biancanev/levitas_pcb/pcb/levitas_v2/Levitas3_Chip_Project/schematic_preview.png

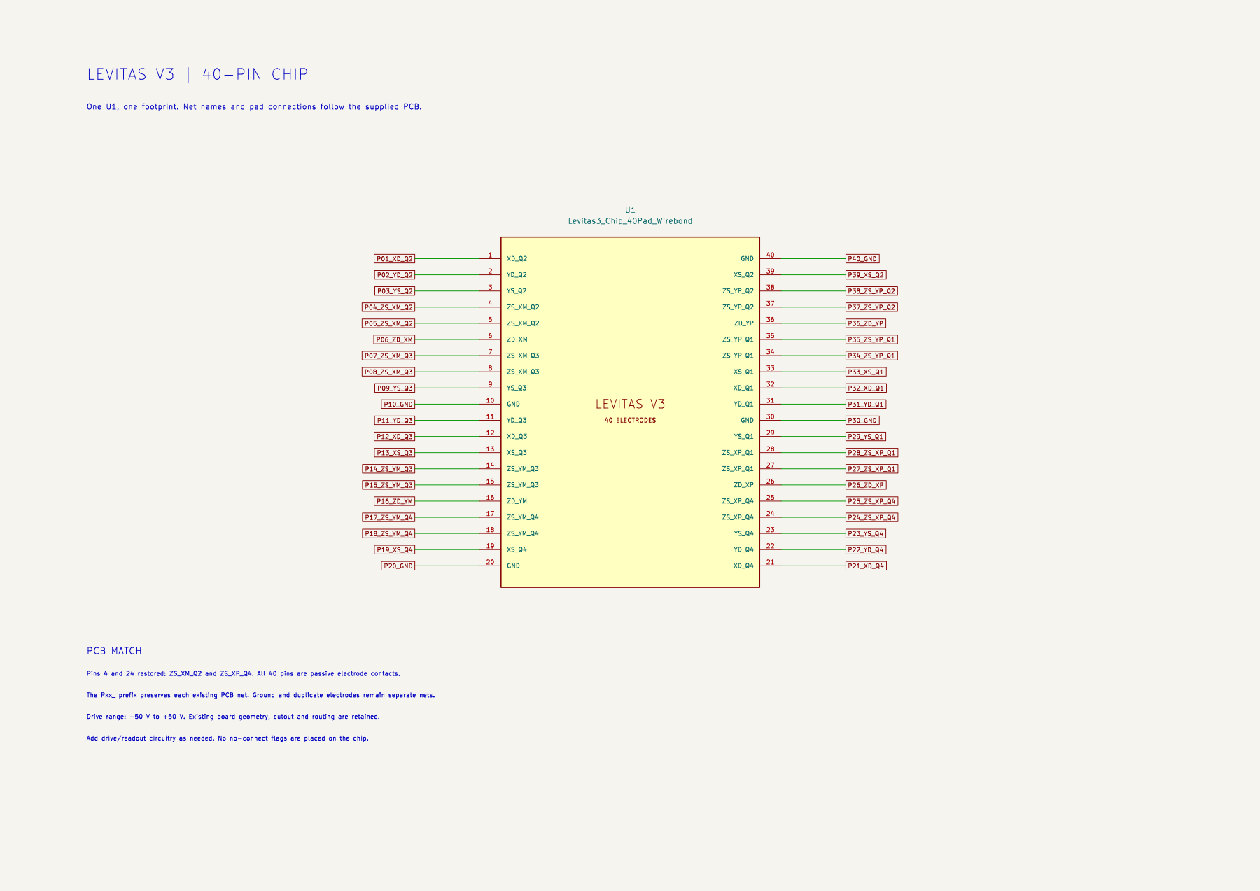
pcb/levitas_v2/Levitas3_Chip_Project/schematic_preview.png
