biancanev/levitas_pcb/pcb/levitas_v2/production/bom.csv

Designator | Footprint | Quantity | Value | LCSC Part #
C1, C10, C13, C16, C19, C22, C4, C41, C43, C45, C7 | 0805 | 11 | 4.7u
C11, C14, C17, C2, C20, C23, C39, C40, C42, C46, C5, C8 | 0603 | 12 | 100n
C12, C15, C18, C21, C24, C3, C6, C9 | 0603 | 8 | 33p
C25, C26, C27, C28, C29, C30, C31, C32, C33, C34, C35, C36 | 0805 | 12 | 470p
C37, C38 | 0805 | 2 | 1u
C39_2 | 0603 | 1 | 0.1u
C44 | C_Disc_D7.5mm_W2.5mm_P5.00mm | 1 | 10n
D1 | LED_D5.0mm | 1 | LED
D2 | D_DO-41_SOD81_P10.16mm_Horizontal | 1 | D
D3 | D_DO-41_SOD81_P10.16mm_Horizontal | 1 | 1N1004
F1, F2, F3, F4 | R_Axial_DIN0207_L6.3mm_D2.5mm_P7.62mm_Horizontal | 4 | Polyfuse
J1 | PinSocket_1x20_P2.54mm_Vertical | 1 | RPI_L
J19 | PinHeader_1x02_P2.54mm_Vertical | 1 | J_DA_CSM
J2 | PinSocket_1x20_P2.54mm_Vertical | 1 | RPI_R
J20 | PinHeader_1x02_P2.54mm_Vertical | 1 | J_DB_SCLK
J21 | PinHeader_1x02_P2.54mm_Vertical | 1 | J_DA_MOSI
J22 | PinHeader_1x04_P2.54mm_Vertical | 1 | J_HV_OUT
J23 | PinHeader_1x02_P2.54mm_Vertical | 1 | J_3V3_EXT
J3 | PinHeader_1x04_P2.54mm_Vertical | 1 | J_HVA
J4 | PinHeader_1x04_P2.54mm_Vertical | 1 | J_HVB
J5 | PinHeader_1x04_P2.54mm_Vertical | 1 | J_HVC
J6 | PinHeader_1x24_P2.54mm_Vertical | 1 | J_HV
J7 | PinSocket_1x08_P2.54mm_Vertical | 1 | J_MPU
JP23 | PinHeader_1x02_P2.54mm_Vertical | 1 | Jumper_2_Bridged
L1, L2, L3, L4, L5, L6, L7, L8 | 0603 | 8 | 18u
R1, R10, R11, R12, R13, R14, R15, R16, R2, R3, R4, R5, R6, R7, R8, R9 | 0603 | 16 | 4.7k
R17, R18, R19, R20, R21, R22, R23, R24, R25, R26, R27, R28 | 1206 | 12 | 10k
R29, R34, R35, R36 | R_Axial_DIN0207_L6.3mm_D2.5mm_P7.62mm_Horizontal | 4 | 5k
R32 | R_Axial_DIN0207_L6.3mm_D2.5mm_P7.62mm_Horizontal | 1 | 220
R33 | R_Axial_DIN0207_L6.3mm_D2.5mm_P7.62mm_Horizontal | 1 | 1M
TP1 | TestPoint_Pad_D1.0mm | 1 | 3V3_A_TP
TP10, TP12, TP14, TP16, TP2, TP4, TP6, TP8 | TestPoint_Pad_D1.0mm | 8 | TestPoint
TP3 | TestPoint_Pad_D1.0mm | 1 | 5v_TP
TP5 | TestPoint_Pad_D1.0mm | 1 | GND_TP
U1 | Levitas3_Chip_40Pad_Wirebond | 1 | Levitas3_Chip_40Pad_Wirebond
U10 | TSSOP-24_4.4x7.8mm_P0.65mm | 1 | HV264
U11 | DRV0006A | 1 | TLV75533PDRVR
U12 | TSSOP-14_4.4x5mm_P0.65mm | 1 | MAX5715
U13 | Q025-5C | 1 | Q025-5C
U2, U3, U4, U5, U6, U7, U8, U9 | WSON-12-1EP_4x4mm_P0.5mm_EP2.6x3mm | 8 | FDC2112
