biancanev/levitas_pcb/pcb/levitas_v2/levitas_v2.csv

Reference | Qty | Value | DNP | Exclude from BOM | Exclude from Board | Footprint | Datasheet
C1,C4,C7,C10,C13,C16,C19,C22 | 8 | 4.7u |  |  |  | Capacitor_SMD:C_0805_2012Metric
C2,C5,C8,C11,C14,C17,C20,C23 | 8 | 100n |  |  |  | Capacitor_SMD:C_0603_1608Metric
C3,C6,C9,C12,C15,C18,C21,C24 | 8 | 33p |  |  |  | Capacitor_SMD:C_0504_1310Metric_Pad0.83x1.28mm_HandSolder
C25,C26,C27,C28,C29,C30,C31,C32,C33,C34,C35,C36 | 12 | 470p
C37,C38 | 2 | 1u
C39 | 1 | 0.1u
J1 | 1 | RPI_L |  |  |  | Connector_PinSocket_2.54mm:PinSocket_1x20_P2.54mm_Vertical
J2 | 1 | RPI_R |  |  |  | Connector_PinSocket_2.54mm:PinSocket_1x20_P2.54mm_Vertical
J3 | 1 | J_HVA |  |  |  | Connector_PinHeader_2.54mm:PinHeader_1x04_P2.54mm_Vertical
J4 | 1 | J_HVB |  |  |  | Connector_PinHeader_2.54mm:PinHeader_1x04_P2.54mm_Vertical
J5 | 1 | J_HVC |  |  |  | Connector_PinHeader_2.54mm:PinHeader_1x04_P2.54mm_Vertical
J6 | 1 | J_HV |  |  |  | Connector_PinHeader_2.54mm:PinHeader_1x24_P2.54mm_Vertical
J7 | 1 | J_MPU |  |  |  | Connector_PinSocket_2.54mm:PinSocket_1x08_P2.54mm_Vertical
L1,L2,L3,L4,L5,L6,L7,L8 | 8 | 18u |  |  |  | Inductor_SMD:L_0603_1608Metric
R1,R2,R3,R4,R5,R6,R7,R8,R9,R10,R11,R12,R13,R14,R15,R16 | 16 | 4.7k |  |  |  | Resistor_SMD:R_0603_1608Metric
R17,R18,R19,R20,R21,R22,R23,R24,R25,R26,R27,R28 | 12 | 10k
TP1 | 1 | 3V3_A_TP |  |  |  | TestPoint:TestPoint_Pad_D1.0mm
TP2,TP4,TP6,TP8,TP10,TP12,TP14,TP16 | 8 | TestPoint |  |  |  | TestPoint:TestPoint_Pad_D1.0mm
TP3 | 1 | 5v_TP |  |  |  | TestPoint:TestPoint_Pad_D1.0mm
TP5 | 1 | GND_TP |  |  |  | TestPoint:TestPoint_Pad_D1.0mm
U1 | 1 | Levitas3_Chip_40Pad_Wirebond |  |  |  | levitas_v3_footprint:Levitas3_Chip_40Pad_Wirebond
U2,U3,U4,U5,U6,U7,U8,U9 | 8 | FDC2112 |  |  |  | levitas_local:WSON-12-1EP_4x4mm_P0.5mm_EP2.6x3mm
U10 | 1 | 74AHCT244 |  |  |  |  | https://assets.nexperia.com/documents/data-sheet/74AHC_AHCT244.pdf
U11 | 1 | TLV75533PDRVR |  |  |  | TLV755:DRV0006A | https://www.ti.com/lit/gpn/tlv755p
