biancanev/levitas_pcb/(list of files, drawings)

Other design files:
pcb/levitas_v2/Levitas3_Chip_Project/source/pcb_pin_map.json
