biancanev/levitas_pcb/pcb/levitas_v2/levitas_v2.kicad_pcb

## KiCad design pcb/levitas_v2/levitas_v2.kicad_pcb (2026-11-06)

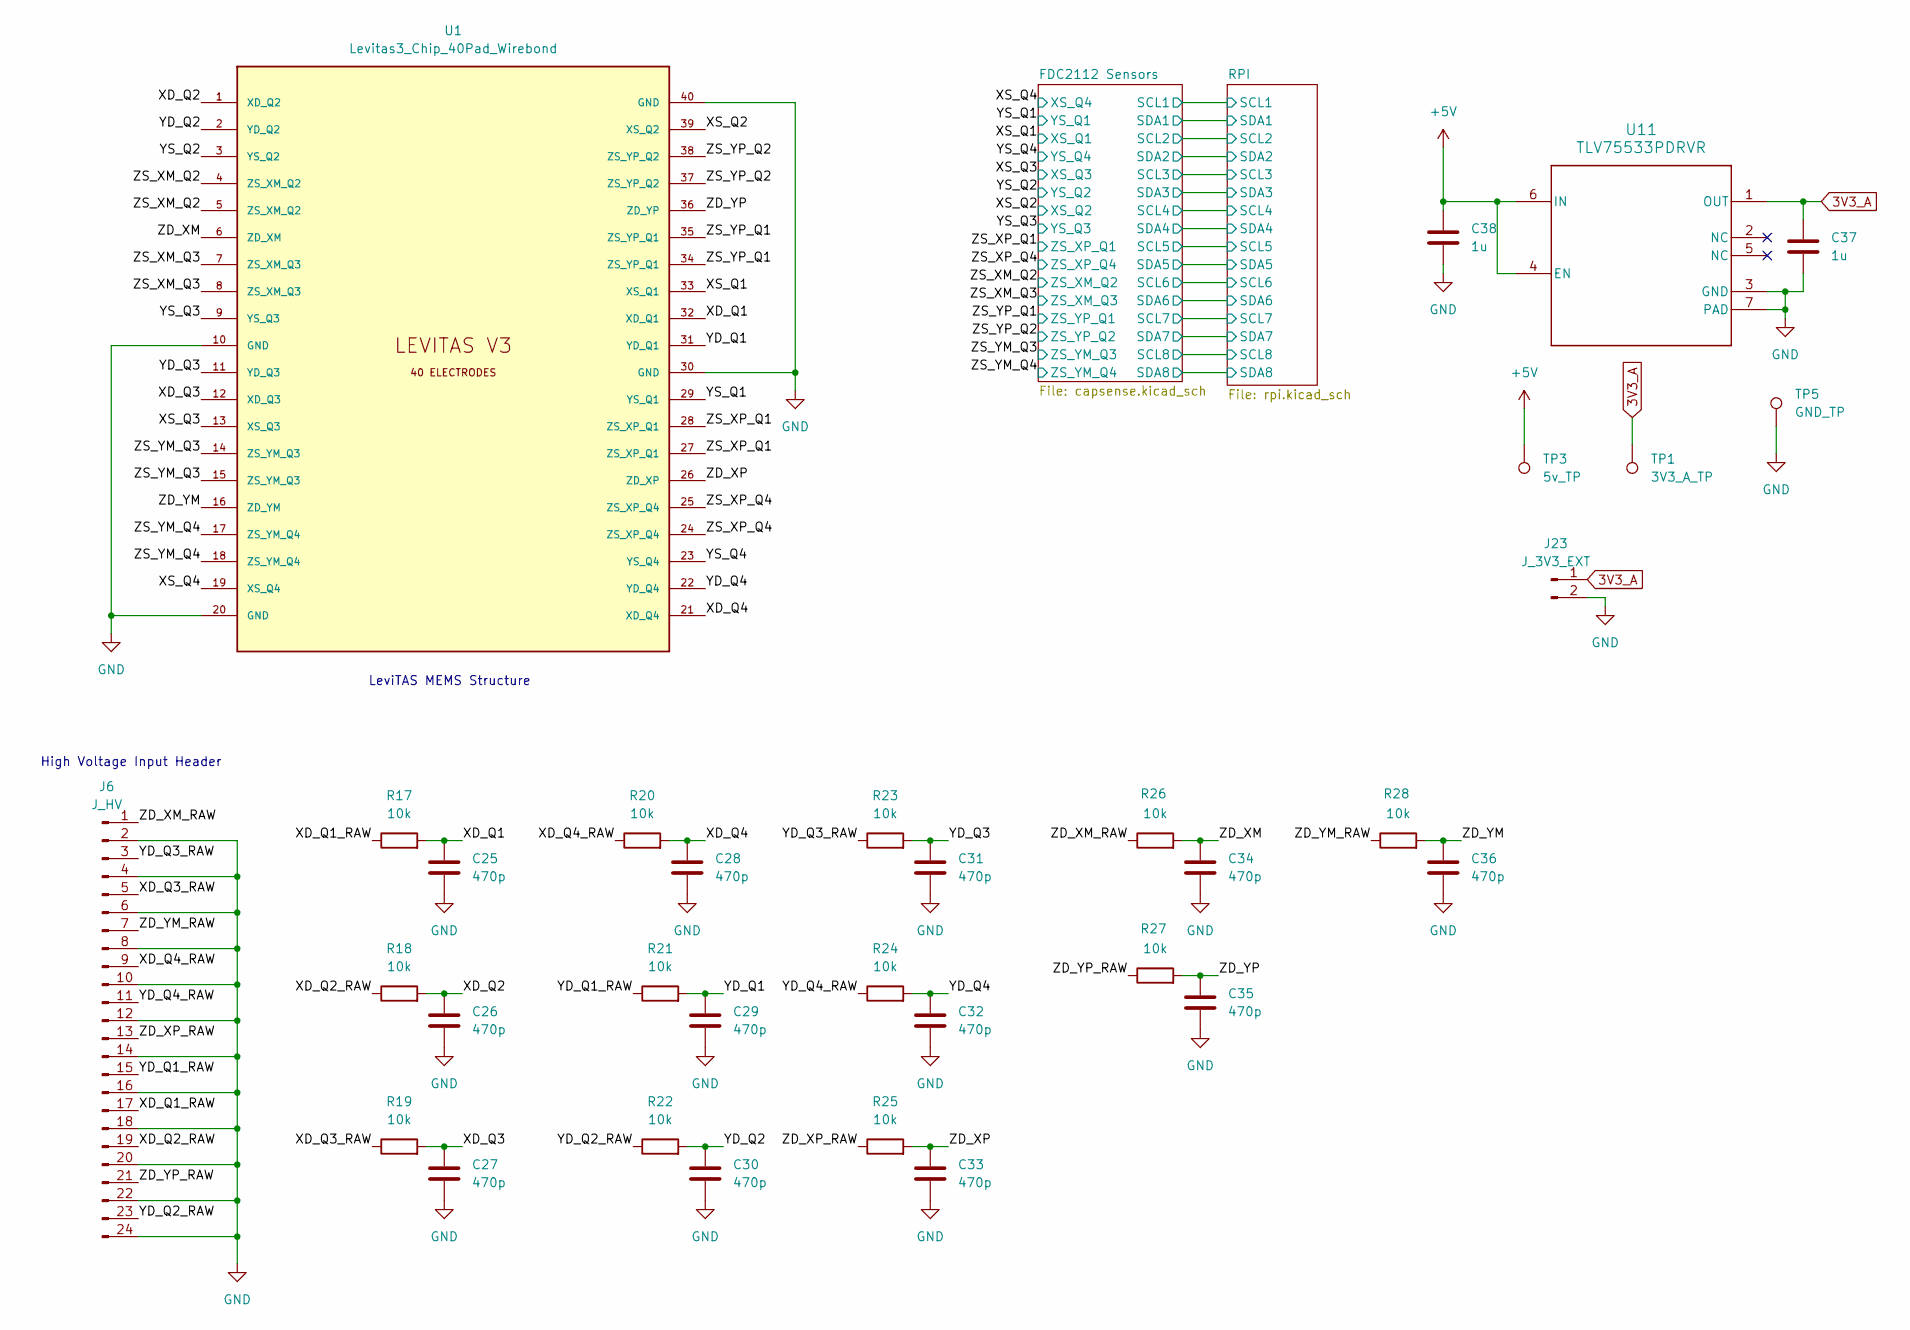
[picture p2: schematic levitas_v2.kicad_sch]

Parts:
C25, C26, C27, C28, C29, C30, C31, C32, C33, C34, C35, C36: 470p; C_0805_2012Metric
C37, C38: 1u; C_0805_2012Metric
J6: J_HV; PinHeader_1x24_P2.54mm_Vertical
J23: J_3V3_EXT; PinHeader_1x02_P2.54mm_Vertical
R17, R18, R19, R20, R21, R22, R23, R24, R25, R26, R27, R28: 10k; R_1206_3216Metric
TP1: 3V3_A_TP; TestPoint_Pad_D1.0mm
TP3: 5v_TP; TestPoint_Pad_D1.0mm
TP5: GND_TP; TestPoint_Pad_D1.0mm
U1: Levitas3_Chip_40Pad_Wirebond
U11: TLV75533PDRVR; DRV0006A

Connections:
/XD_Q1: C25.1, R17.2, U1.32 (XD_Q1)
/XD_Q1_RAW: J6.17, R17.1
/XD_Q2: C26.1, R18.2, U1.1 (XD_Q2)
/XD_Q2_RAW: J6.19, R18.1
/XD_Q3: C27.1, R19.2, U1.12 (XD_Q3)
/XD_Q3_RAW: J6.5, R19.1
/XD_Q4: C28.1, R20.2, U1.21 (XD_Q4)
/XD_Q4_RAW: J6.9, R20.1
/XS_Q1: U1.33 (XS_Q1); also elsewhere on the board
/XS_Q2: U1.39 (XS_Q2); also elsewhere on the board
/XS_Q3: U1.13 (XS_Q3); also elsewhere on the board
/XS_Q4: U1.19 (XS_Q4); also elsewhere on the board
/YD_Q1: C29.1, R21.2, U1.31 (YD_Q1)
/YD_Q1_RAW: J6.15, R21.1
/YD_Q2: C30.1, R22.2, U1.2 (YD_Q2)
/YD_Q2_RAW: J6.23, R22.1
/YD_Q3: C31.1, R23.2, U1.11 (YD_Q3)
/YD_Q3_RAW: J6.3, R23.1
/YD_Q4: C32.1, R24.2, U1.22 (YD_Q4)
/YD_Q4_RAW: J6.11, R24.1
/YS_Q1: U1.29 (YS_Q1); also elsewhere on the board
/YS_Q2: U1.3 (YS_Q2); also elsewhere on the board
/YS_Q3: U1.9 (YS_Q3); also elsewhere on the board
/YS_Q4: U1.23 (YS_Q4); also elsewhere on the board
/ZD_XM: C34.1, R26.2, U1.6 (ZD_XM)
/ZD_XM_RAW: J6.1, R26.1
/ZD_XP: C33.1, R25.2, U1.26 (ZD_XP)
/ZD_XP_RAW: J6.13, R25.1
/ZD_YM: C36.1, R28.2, U1.16 (ZD_YM)
/ZD_YM_RAW: J6.7, R28.1
/ZD_YP: C35.1, R27.2, U1.36 (ZD_YP)
/ZD_YP_RAW: J6.21, R27.1
/ZS_XM_Q2: U1.4 (ZS_XM_Q2), U1.5 (ZS_XM_Q2); also elsewhere on the board
/ZS_XM_Q3: U1.7 (ZS_XM_Q3), U1.8 (ZS_XM_Q3); also elsewhere on the board
/ZS_XP_Q1: U1.27 (ZS_XP_Q1), U1.28 (ZS_XP_Q1); also elsewhere on the board
/ZS_XP_Q4: U1.24 (ZS_XP_Q4), U1.25 (ZS_XP_Q4); also elsewhere on the board
/ZS_YM_Q3: U1.14 (ZS_YM_Q3), U1.15 (ZS_YM_Q3); also elsewhere on the board
/ZS_YM_Q4: U1.17 (ZS_YM_Q4), U1.18 (ZS_YM_Q4); also elsewhere on the board
/ZS_YP_Q1: U1.34 (ZS_YP_Q1), U1.35 (ZS_YP_Q1); also elsewhere on the board
/ZS_YP_Q2: U1.37 (ZS_YP_Q2), U1.38 (ZS_YP_Q2); also elsewhere on the board
GND: C25.2, C26.2, C27.2, C28.2, C29.2, C30.2, C31.2, C32.2, C33.2, C34.2, C35.2, C36.2, C37.2, C38.2, J6.2, J6.4, J6.6, J6.8, J6.10, J6.12, J6.14, J6.16, J6.18, J6.20, J6.22, J6.24, J23.2, TP5.1 (1_1), U1.10 (GND), U1.20 (GND), U1.30 (GND), U1.40 (GND), U11.3 (GND), U11.7 (PAD); also elsewhere on the board

Notes on the sheet:
High Voltage Input Header
LeviTAS MEMS Structure

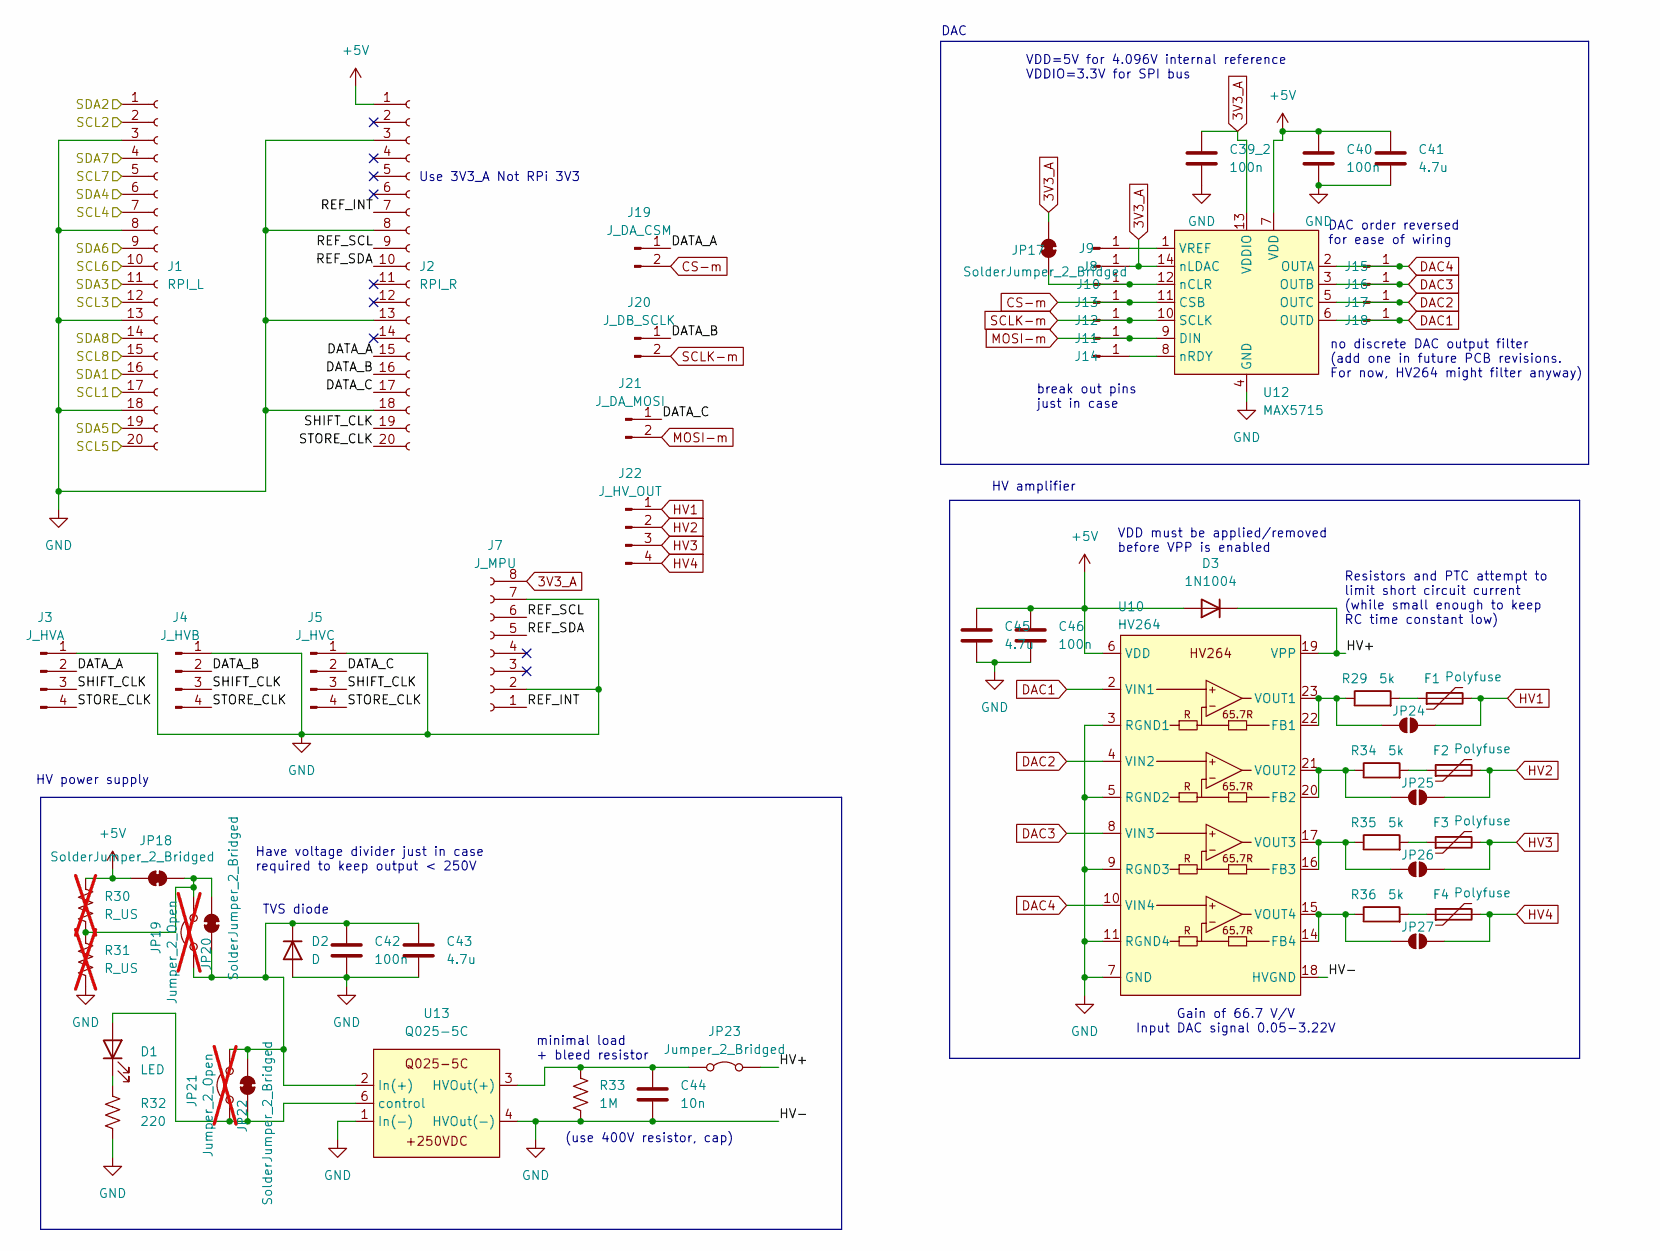
[picture p3: schematic rpi.kicad_sch]

Parts:
C39_2, C40, C42, C46: 100n; C_0603_1608Metric
C41, C43, C45: 4.7u; C_0805_2012Metric
C44: 10n; C_Disc_D7.5mm_W2.5mm_P5.00mm
D1: LED; LED_D5.0mm
D2: D; D_DO-41_SOD81_P10.16mm_Horizontal
D3: 1N1004; D_DO-41_SOD81_P10.16mm_Horizontal
F1, F2, F3, F4: Polyfuse; R_Axial_DIN0207_L6.3mm_D2.5mm_P7.62mm_Horizontal
J1: RPI_L; PinSocket_1x20_P2.54mm_Vertical
J2: RPI_R; PinSocket_1x20_P2.54mm_Vertical
J3: J_HVA; PinHeader_1x04_P2.54mm_Vertical
J4: J_HVB; PinHeader_1x04_P2.54mm_Vertical
J5: J_HVC; PinHeader_1x04_P2.54mm_Vertical
J7: J_MPU; PinSocket_1x08_P2.54mm_Vertical
J8, J9, J10, J11, J12, J13, J14, J15, J16, J17, J18: Conn_01x01_Pin; TestPoint_Pad_D2.0mm
J19: J_DA_CSM; PinHeader_1x02_P2.54mm_Vertical
J20: J_DB_SCLK; PinHeader_1x02_P2.54mm_Vertical
J21: J_DA_MOSI; PinHeader_1x02_P2.54mm_Vertical
J22: J_HV_OUT; PinHeader_1x04_P2.54mm_Vertical
JP17, JP18, JP20, JP22: SolderJumper_2_Bridged; SolderJumper-2_P1.3mm_Bridged_RoundedPad1.0x1.5mm
JP19, JP21: Jumper_2_Open; PinHeader_1x02_P2.54mm_Vertical; not fitted
JP23: Jumper_2_Bridged; PinHeader_1x02_P2.54mm_Vertical
JP24, JP25, JP26, JP27: SolderJumper_2_Open; SolderJumper-2_P1.3mm_Open_RoundedPad1.0x1.5mm
R29, R34, R35, R36: 5k; R_Axial_DIN0207_L6.3mm_D2.5mm_P7.62mm_Horizontal
R30, R31: R_US; R_Axial_DIN0207_L6.3mm_D2.5mm_P7.62mm_Horizontal; not fitted
R32: 220; R_Axial_DIN0207_L6.3mm_D2.5mm_P7.62mm_Horizontal
R33: 1M; R_Axial_DIN0207_L6.3mm_D2.5mm_P7.62mm_Horizontal
U10: HV264; TSSOP-24_4.4x7.8mm_P0.65mm
U12: MAX5715; TSSOP-14_4.4x5mm_P0.65mm
U13: Q025-5C

Connections:
/FDC2112 Sensors/SCL1: J1.17; also elsewhere on the board
/FDC2112 Sensors/SCL2: J1.2; also elsewhere on the board
/FDC2112 Sensors/SCL3: J1.12; also elsewhere on the board
/FDC2112 Sensors/SCL4: J1.7; also elsewhere on the board
/FDC2112 Sensors/SCL5: J1.20; also elsewhere on the board
/FDC2112 Sensors/SCL6: J1.10; also elsewhere on the board
/FDC2112 Sensors/SCL7: J1.5; also elsewhere on the board
/FDC2112 Sensors/SCL8: J1.15; also elsewhere on the board
/FDC2112 Sensors/SDA1: J1.16; also elsewhere on the board
/FDC2112 Sensors/SDA2: J1.1; also elsewhere on the board
/FDC2112 Sensors/SDA3: J1.11; also elsewhere on the board
/FDC2112 Sensors/SDA4: J1.6; also elsewhere on the board
/FDC2112 Sensors/SDA5: J1.19; also elsewhere on the board
/FDC2112 Sensors/SDA6: J1.9; also elsewhere on the board
/FDC2112 Sensors/SDA7: J1.4; also elsewhere on the board
/FDC2112 Sensors/SDA8: J1.14; also elsewhere on the board
/RPI/DATA_A: J2.15, J3.2, J19.1
/RPI/DATA_B: J2.16, J4.2, J20.1
/RPI/DATA_C: J2.17, J5.2, J21.1
/RPI/HV+: D3.1 (K), JP23.2 (B), U10.19 (VPP)
/RPI/REF_INT: J2.7, J7.1
/RPI/REF_SCL: J2.9, J7.6
/RPI/REF_SDA: J2.10, J7.5
/RPI/SHIFT_CLK: J2.19, J3.3, J4.3, J5.3
/RPI/STORE_CLK: J2.20, J3.4, J4.4, J5.4
CS-m: J13.1, J19.2, U12.11 (CSB)
DAC1: J18.1, U10.2 (VIN1), U12.6 (OUTD)
DAC2: J17.1, U10.4 (VIN2), U12.5 (OUTC)
DAC3: J16.1, U10.8 (VIN3), U12.3 (OUTB)
DAC4: J15.1, U10.10 (VIN4), U12.2 (OUTA)
GND: C39_2.2, C40.2, C41.2, C42.2, C43.2, C44.2, C45.2, C46.2, D2.2 (A), J1.3, J1.8, J1.13, J1.18, J2.3, J2.8, J2.13, J2.18, J3.1, J4.1, J5.1, J7.2, J7.7, R31.2, R32.2, R33.2, U10.3 (RGND1), U10.5 (RGND2), U10.7 (GND), U10.9 (RGND3), U10.11 (RGND4), U10.18 (HVGND), U12.4 (GND), U13.1 (In(-)), U13.4 (HVOut(-)); also elsewhere on the board
HV1: F1.2, J22.1, JP24.2 (B)
HV2: F2.2, J22.2, JP25.2 (B)
HV3: F3.2, J22.3, JP26.2 (B)
HV4: F4.2, J22.4, JP27.2 (B)
MOSI-m: J11.1, J21.2, U12.9 (DIN)
unnamed: D1.2 (A), JP21.1 (A), JP22.1 (A), U13.6 (control)
unnamed: D1.1 (K), R32.1
unnamed: C42.1, C43.1, D2.1 (K), JP19.1 (A), JP20.1 (A), JP21.2 (B), JP22.2 (B), U13.2 (In(+))
unnamed: F1.1, R29.2
unnamed: F2.1, R34.2
unnamed: F3.1, R35.2
unnamed: F4.1, R36.2
unnamed: J9.1, U12.1 (VREF)
unnamed: J10.1, JP17.2 (B), U12.12 (nCLR)
unnamed: J14.1, U12.8 (nRDY)
unnamed: JP18.1 (A), JP19.2 (B), JP20.2 (B), R30.2, R31.1
unnamed: C44.1, JP23.1 (A), R33.1, U13.3 (HVOut(+))
unnamed: JP24.1 (A), R29.1, U10.22 (FB1), U10.23 (VOUT1)
unnamed: JP25.1 (A), R34.1, U10.20 (FB2), U10.21 (VOUT2)
unnamed: JP26.1 (A), R35.1, U10.16 (FB3), U10.17 (VOUT3)
unnamed: JP27.1 (A), R36.1, U10.14 (FB4), U10.15 (VOUT4)
SCLK-m: J12.1, J20.2, U12.10 (SCLK)

Notes on the sheet:
VDD=5V for 4.096V internal reference VDDIO=3.3V for SPI bus
DAC
VDD must be applied/removed before VPP is enabled
Resistors and PTC attempt to limit short circuit current (while small enough to keep RC time constant low)
TVS diode
DAC order reversed for ease of wiring
minimal load + bleed resistor
Have voltage divider just in case required to keep output < 250V
HV power supply
(use 400V resistor, cap)
break out pins just in case
Use 3V3_A Not RPi 3V3
no discrete DAC output filter (add one in future PCB revisions. For now, HV264 might filter anyway)
Gain of 66.7 V/V Input DAC signal 0.05-3.22V
HV amplifier

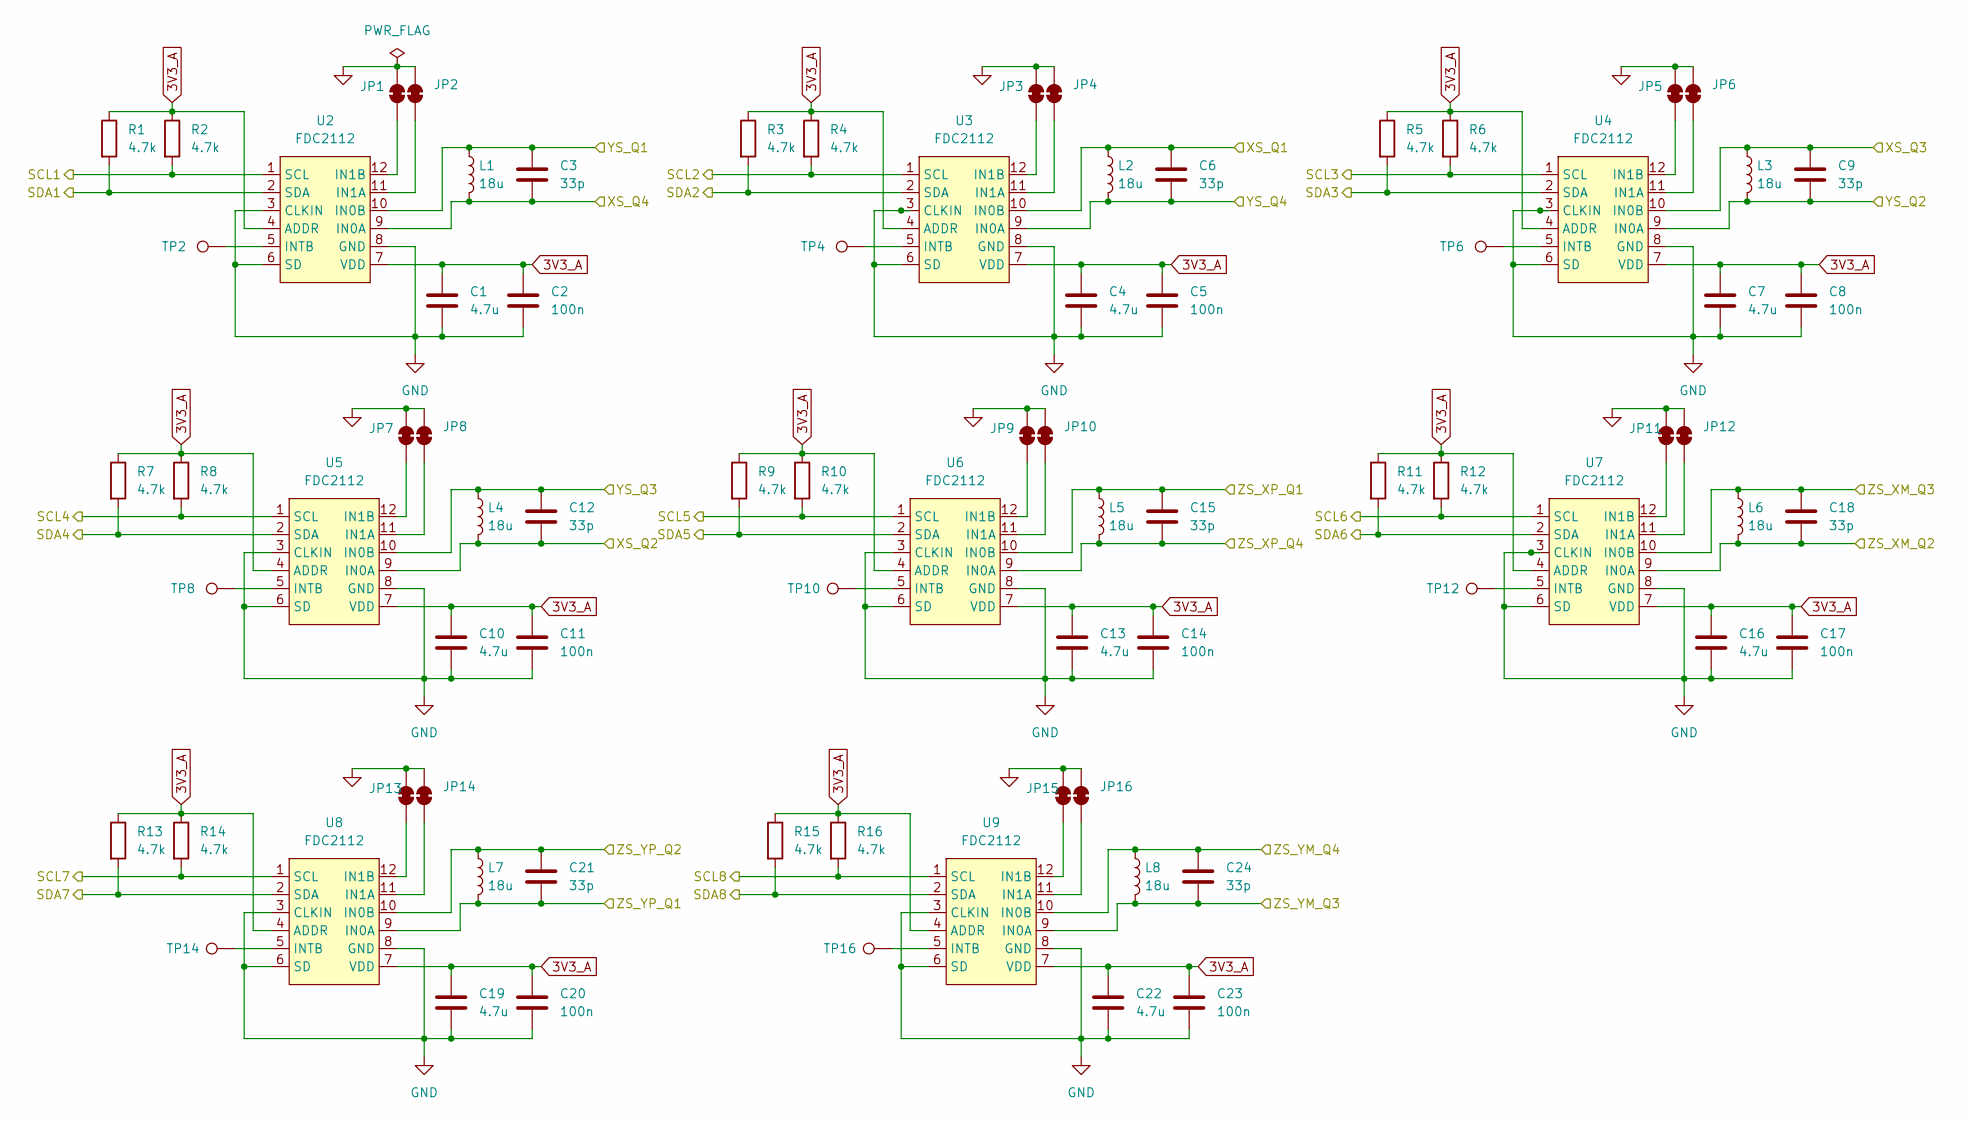
[picture p4: schematic capsense.kicad_sch]

Parts:
C1, C4, C7, C10, C13, C16, C19, C22: 4.7u; C_0805_2012Metric
C2, C5, C8, C11, C14, C17, C20, C23: 100n; C_0603_1608Metric
C3, C6, C9, C12, C15, C18, C21, C24: 33p; C_0603_1608Metric
JP1, JP2, JP3, JP4, JP5, JP6, JP7, JP8, JP9, JP10, JP11, JP12, JP13, JP14, JP15, JP16: SolderJumper_2_Bridged; SolderJumper-2_P1.3mm_Bridged_RoundedPad1.0x1.5mm
L1, L2, L3, L4, L5, L6, L7, L8: 18u; L_0603_1608Metric
R1, R2, R3, R4, R5, R6, R7, R8, R9, R10, R11, R12, R13, R14, R15, R16: 4.7k; R_0603_1608Metric
TP2, TP4, TP6, TP8, TP10, TP12, TP14, TP16: TestPoint; TestPoint_Pad_D1.0mm
U2, U3, U4, U5, U6, U7, U8, U9: FDC2112; WSON-12-1EP_4x4mm_P0.5mm_EP2.6x3mm

Connections:
/FDC2112 Sensors/SCL1: R2.2, U2.1 (SCL); also elsewhere on the board
/FDC2112 Sensors/SCL2: R4.2, U3.1 (SCL); also elsewhere on the board
/FDC2112 Sensors/SCL3: R6.2, U4.1 (SCL); also elsewhere on the board
/FDC2112 Sensors/SCL4: R8.2, U5.1 (SCL); also elsewhere on the board
/FDC2112 Sensors/SCL5: R10.2, U6.1 (SCL); also elsewhere on the board
/FDC2112 Sensors/SCL6: R12.2, U7.1 (SCL); also elsewhere on the board
/FDC2112 Sensors/SCL7: R14.2, U8.1 (SCL); also elsewhere on the board
/FDC2112 Sensors/SCL8: R16.2, U9.1 (SCL); also elsewhere on the board
/FDC2112 Sensors/SDA1: R1.2, U2.2 (SDA); also elsewhere on the board
/FDC2112 Sensors/SDA2: R3.2, U3.2 (SDA); also elsewhere on the board
/FDC2112 Sensors/SDA3: R5.2, U4.2 (SDA); also elsewhere on the board
/FDC2112 Sensors/SDA4: R7.2, U5.2 (SDA); also elsewhere on the board
/FDC2112 Sensors/SDA5: R9.2, U6.2 (SDA); also elsewhere on the board
/FDC2112 Sensors/SDA6: R11.2, U7.2 (SDA); also elsewhere on the board
/FDC2112 Sensors/SDA7: R13.2, U8.2 (SDA); also elsewhere on the board
/FDC2112 Sensors/SDA8: R15.2, U9.2 (SDA); also elsewhere on the board
/XS_Q1: C6.1, L2.1, U3.10 (IN0B); also elsewhere on the board
/XS_Q2: C12.2, L4.2, U5.9 (IN0A); also elsewhere on the board
/XS_Q3: C9.1, L3.1, U4.10 (IN0B); also elsewhere on the board
/XS_Q4: C3.2, L1.2, U2.9 (IN0A); also elsewhere on the board
/YS_Q1: C3.1, L1.1, U2.10 (IN0B); also elsewhere on the board
/YS_Q2: C9.2, L3.2, U4.9 (IN0A); also elsewhere on the board
/YS_Q3: C12.1, L4.1, U5.10 (IN0B); also elsewhere on the board
/YS_Q4: C6.2, L2.2, U3.9 (IN0A); also elsewhere on the board
/ZS_XM_Q2: C18.2, L6.2, U7.9 (IN0A); also elsewhere on the board
/ZS_XM_Q3: C18.1, L6.1, U7.10 (IN0B); also elsewhere on the board
/ZS_XP_Q1: C15.1, L5.1, U6.10 (IN0B); also elsewhere on the board
/ZS_XP_Q4: C15.2, L5.2, U6.9 (IN0A); also elsewhere on the board
/ZS_YM_Q3: C24.2, L8.2, U9.9 (IN0A); also elsewhere on the board
/ZS_YM_Q4: C24.1, L8.1, U9.10 (IN0B); also elsewhere on the board
/ZS_YP_Q1: C21.2, L7.2, U8.9 (IN0A); also elsewhere on the board
/ZS_YP_Q2: C21.1, L7.1, U8.10 (IN0B); also elsewhere on the board
GND: C1.2, C2.2, C4.2, C5.2, C7.2, C8.2, C10.2, C11.2, C13.2, C14.2, C16.2, C17.2, C19.2, C20.2, C22.2, C23.2, JP1.2 (B), JP2.2 (B), JP3.2 (B), JP4.2 (B), JP5.2 (B), JP6.2 (B), JP7.2 (B), JP8.2 (B), JP9.2 (B), JP10.2 (B), JP11.2 (B), JP12.2 (B), JP13.2 (B), JP14.2 (B), JP15.2 (B), JP16.2 (B), U2.3 (CLKIN), U2.6 (SD), U2.8 (GND), U3.3 (CLKIN), U3.6 (SD), U3.8 (GND), U4.3 (CLKIN), U4.6 (SD), U4.8 (GND), U5.3 (CLKIN), U5.6 (SD), U5.8 (GND), U6.3 (CLKIN), U6.6 (SD), U6.8 (GND), U7.3 (CLKIN), U7.6 (SD), U7.8 (GND), U8.3 (CLKIN), U8.6 (SD), U8.8 (GND), U9.3 (CLKIN), U9.6 (SD), U9.8 (GND); also elsewhere on the board
unnamed: JP1.1 (A), U2.12 (IN1B)
unnamed: JP2.1 (A), U2.11 (IN1A)
unnamed: JP3.1 (A), U3.12 (IN1B)
unnamed: JP4.1 (A), U3.11 (IN1A)
unnamed: JP5.1 (A), U4.12 (IN1B)
unnamed: JP6.1 (A), U4.11 (IN1A)
unnamed: JP7.1 (A), U5.12 (IN1B)
unnamed: JP8.1 (A), U5.11 (IN1A)
unnamed: JP9.1 (A), U6.12 (IN1B)
unnamed: JP10.1 (A), U6.11 (IN1A)
unnamed: JP11.1 (A), U7.12 (IN1B)
unnamed: JP12.1 (A), U7.11 (IN1A)
unnamed: JP13.1 (A), U8.12 (IN1B)
unnamed: JP14.1 (A), U8.11 (IN1A)
unnamed: JP15.1 (A), U9.12 (IN1B)
unnamed: JP16.1 (A), U9.11 (IN1A)
unnamed: TP2.1 (1_1), U2.5 (INTB)
unnamed: TP4.1 (1_1), U3.5 (INTB)
unnamed: TP6.1 (1_1), U4.5 (INTB)
unnamed: TP8.1 (1_1), U5.5 (INTB)
unnamed: TP10.1 (1_1), U6.5 (INTB)
unnamed: TP12.1 (1_1), U7.5 (INTB)
unnamed: TP14.1 (1_1), U8.5 (INTB)
unnamed: TP16.1 (1_1), U9.5 (INTB)

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
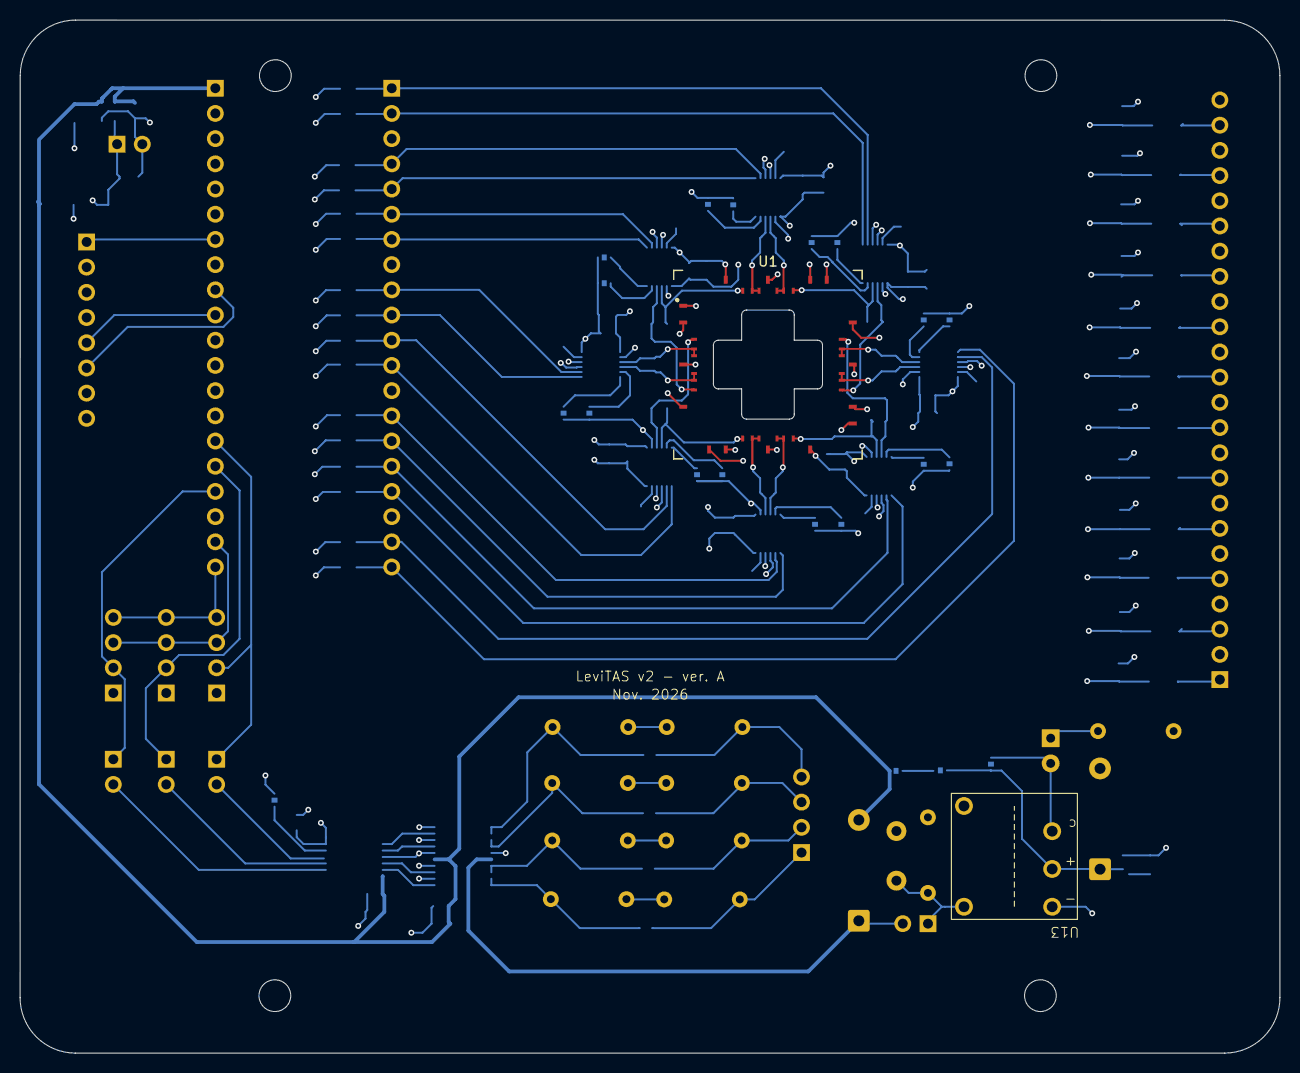
[picture p5: board levitas_v2.kicad_pcb from above]

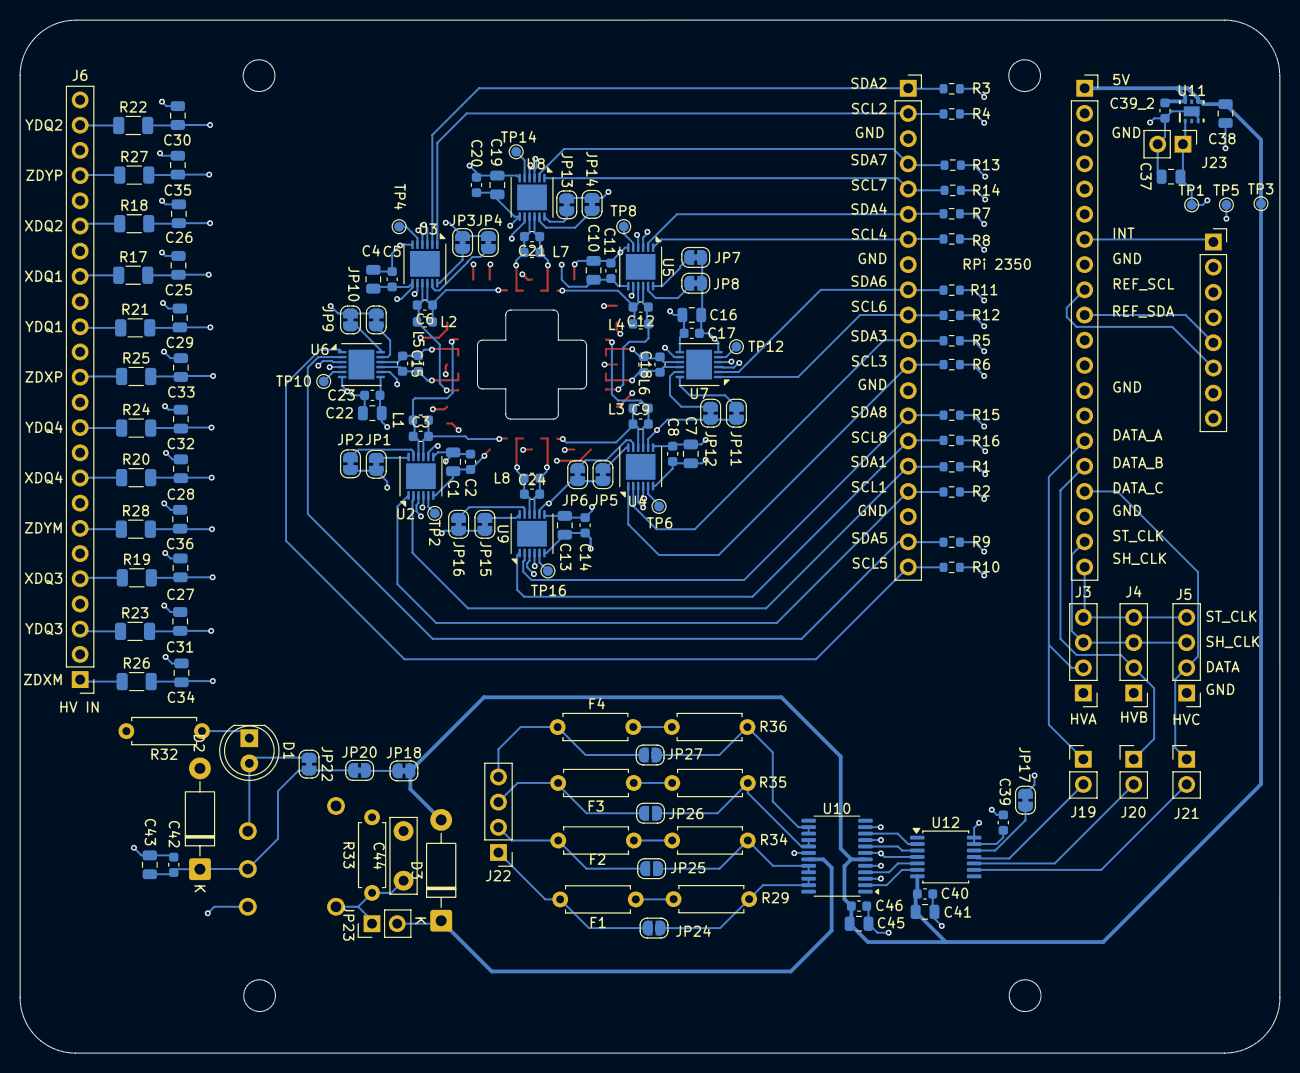
[picture p6: board levitas_v2.kicad_pcb from below]

Board: 4 copper layers, 127.0 x 104.1 mm, 161 parts (155 on the bottom side), 117 nets.

Other parts of the board:
C39: 100n; C_0603_1608Metric
M3_H1, M3_H2, M3_H3, M3_H4: MountingHole_3.2mm_M3

Their connections:
GND: C39.2; also elsewhere on the board
