biancanev/levitas_pcb/(commit log)

2026-10-31 levitas_v2 schematic done. TODO: layout
    [Levitas3_Chip.kicad_pcb, Levitas3_Chip.kicad_sch, capsense.kicad_sch, levitas3_geometry_coupon.kicad_pcb, levitas_v2.kicad_pcb, levitas_v2.kicad_sch, pcb_pin_map.json, rpi.kicad_sch]
2026-11-06 finished v2 pcb
    [capsense.kicad_sch, levitas_v2.csv, levitas_v2.kicad_pcb, levitas_v2.kicad_sch, rpi.kicad_sch]
2026-11-06 m2 -> m3
    [levitas_v2.kicad_pcb]
2026-11-06 fixed cap footprint, fixed mpu reference wiring
    [capsense.kicad_sch, levitas_v2.kicad_pcb, rpi.kicad_sch]
2026-11-06 added production file to JLC
    [bom.csv, designators.csv, levitas_v2.kicad_pcb, levitas_v2_JLC_SMT_BOM_excl_U10.csv, levitas_v2_JLC_SMT_positions_excl_U10.csv, levitas_v2_JLC_excluded_components.csv, positions.csv, rpi.kicad_sch]
